stromberg-DS/KindnessFlower/Graphics/FlowerBase.JPEG

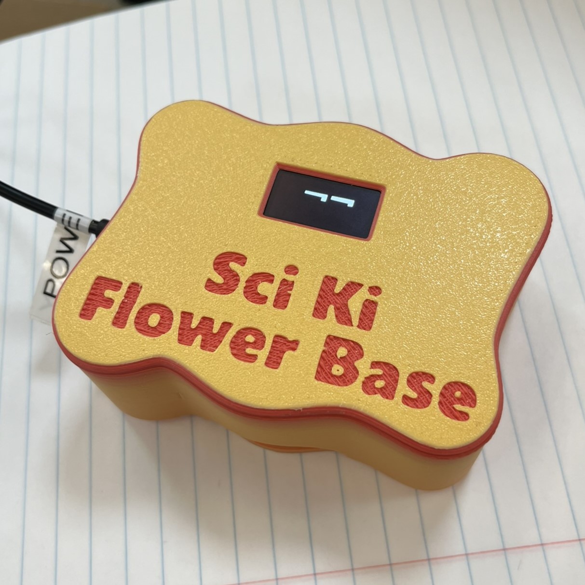
Graphics/FlowerBase.JPEG
