stromberg-DS/KindnessFlower/Graphics/FlowerBase_Wiggly.png

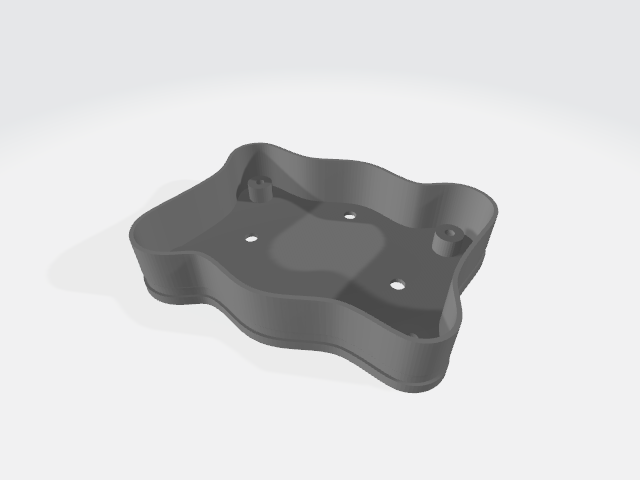
Graphics/FlowerBase_Wiggly.png
