stromberg-DS/KindnessFlower/Graphics/FlowerLid_Wiggly.png

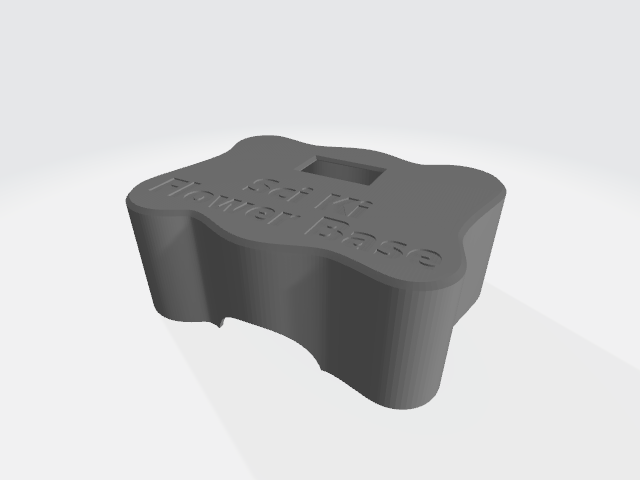
Graphics/FlowerLid_Wiggly.png
