stromberg-DS/KindnessFlower/Graphics/KindFlowerPCB2.png

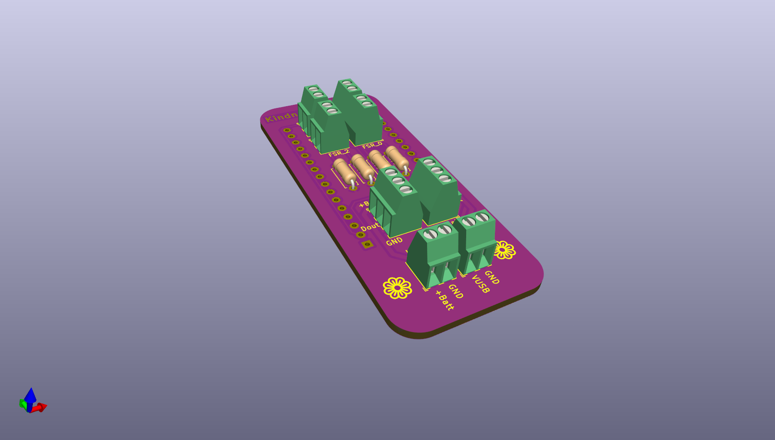
Graphics/KindFlowerPCB2.png
