stromberg-DS/KindnessFlower/Graphics/KindFlowerPCB.png

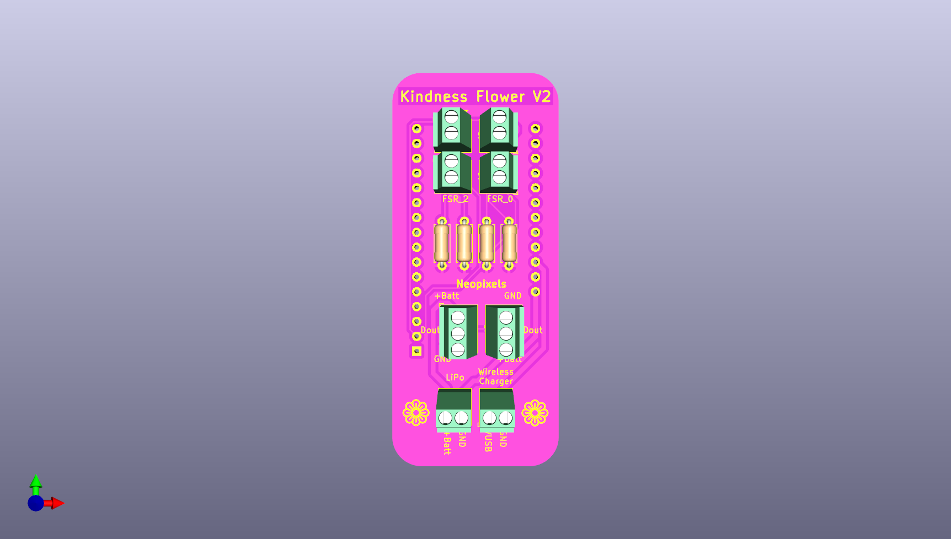
Graphics/KindFlowerPCB.png
