stromberg-DS/KindnessFlower/3D_Files/FlowerBase_Wiggly.stl

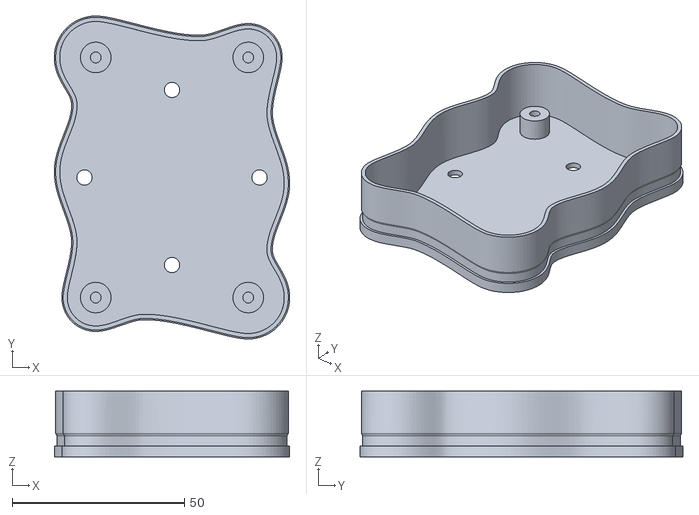
[picture p7: CAD file, 2024-09-27]
3D_Files/FlowerBase_Wiggly.stl
68.3 x 93.7 x 19.0
