stromberg-DS/KindnessFlower/3D_Files/FlowerLid_Wiggly.stl

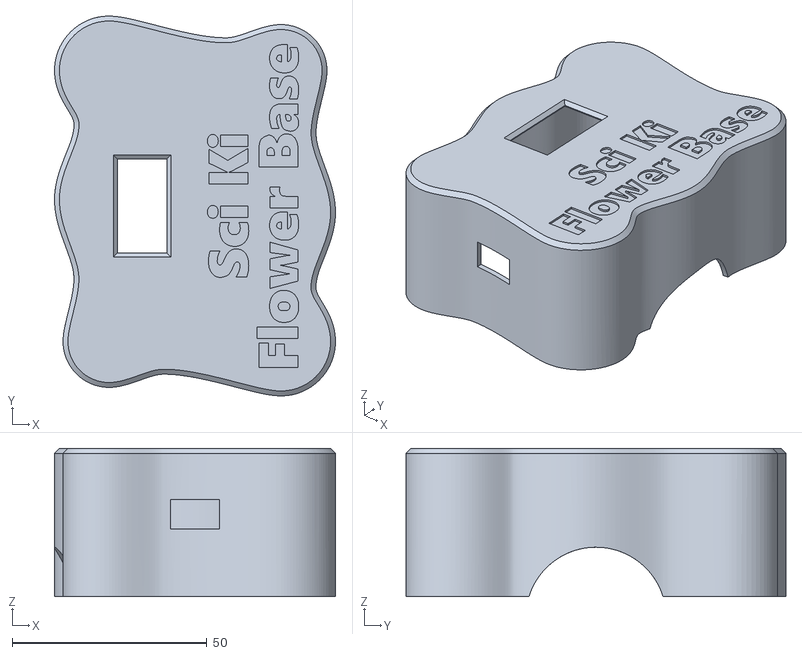
[picture p8: CAD file, 2024-09-27]
3D_Files/FlowerLid_Wiggly.stl
72.2 x 97.6 x 38.1
