stromberg-DS/KindnessFlower/WiringDiagrams/FlowerBase_bb.jpg

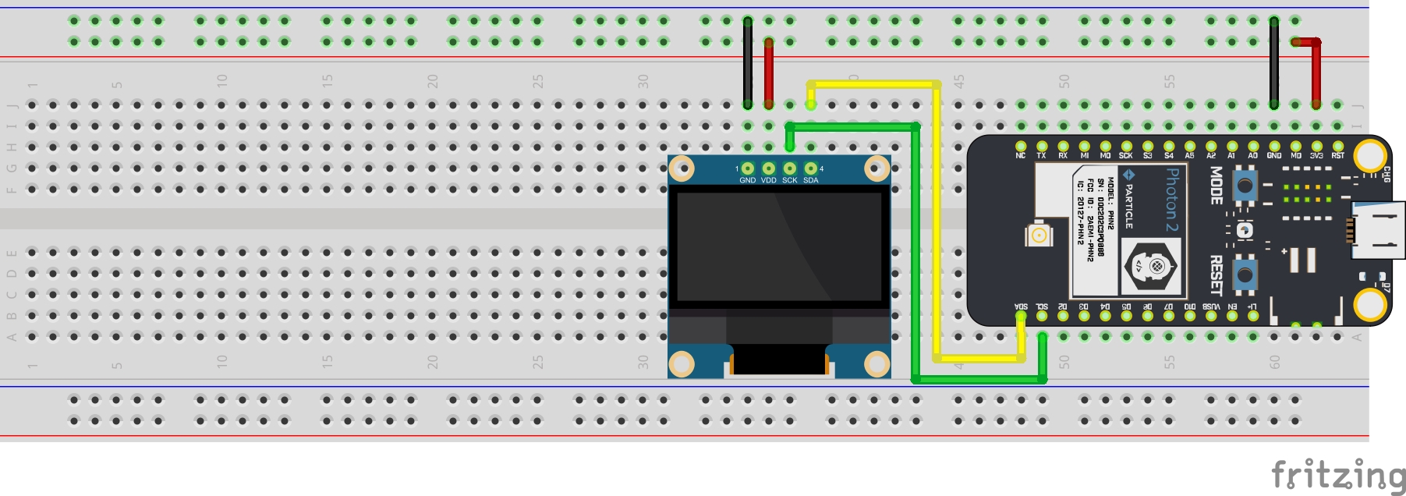
WiringDiagrams/FlowerBase_bb.jpg
