stromberg-DS/KindnessFlower/WiringDiagrams/FlowerBase_schem.jpg

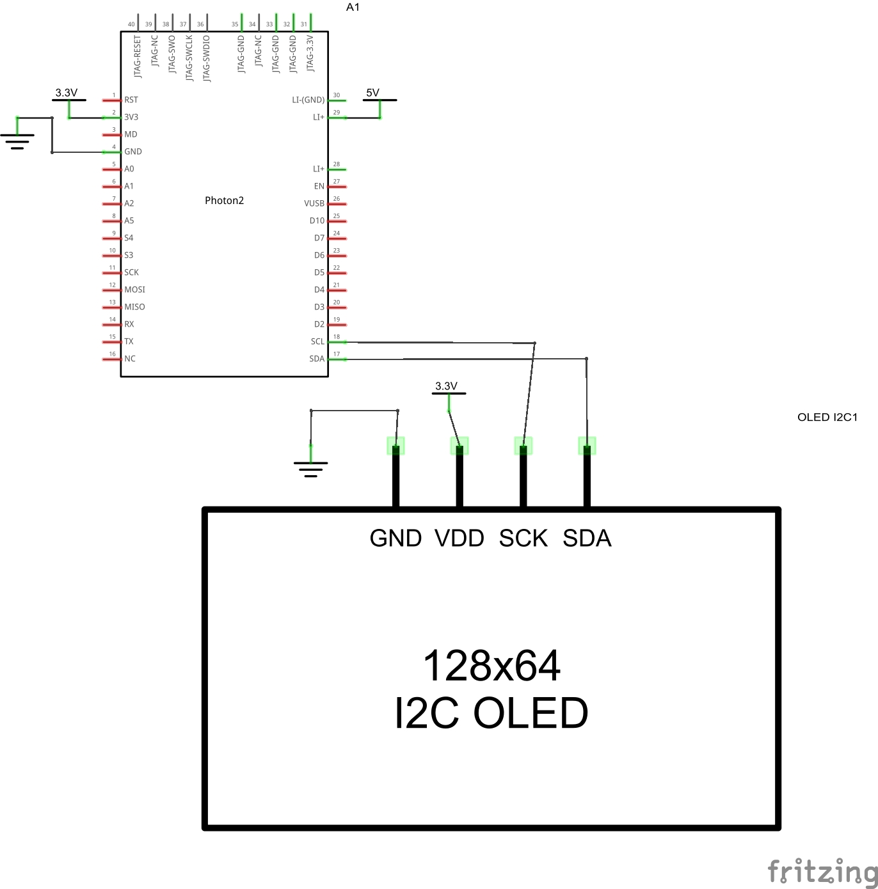
WiringDiagrams/FlowerBase_schem.jpg
