stromberg-DS/KindnessFlower/WiringDiagrams/FlowerWiring_bb.jpg

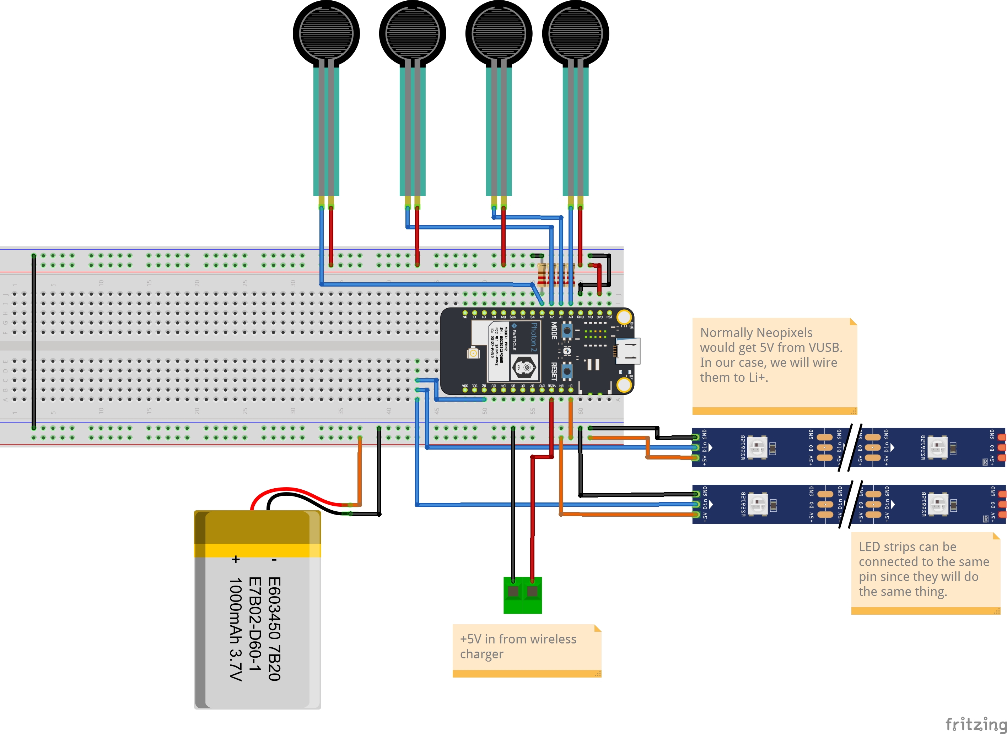
WiringDiagrams/FlowerWiring_bb.jpg
