stromberg-DS/KindnessFlower/WiringDiagrams/FlowerWiring_schem.jpg

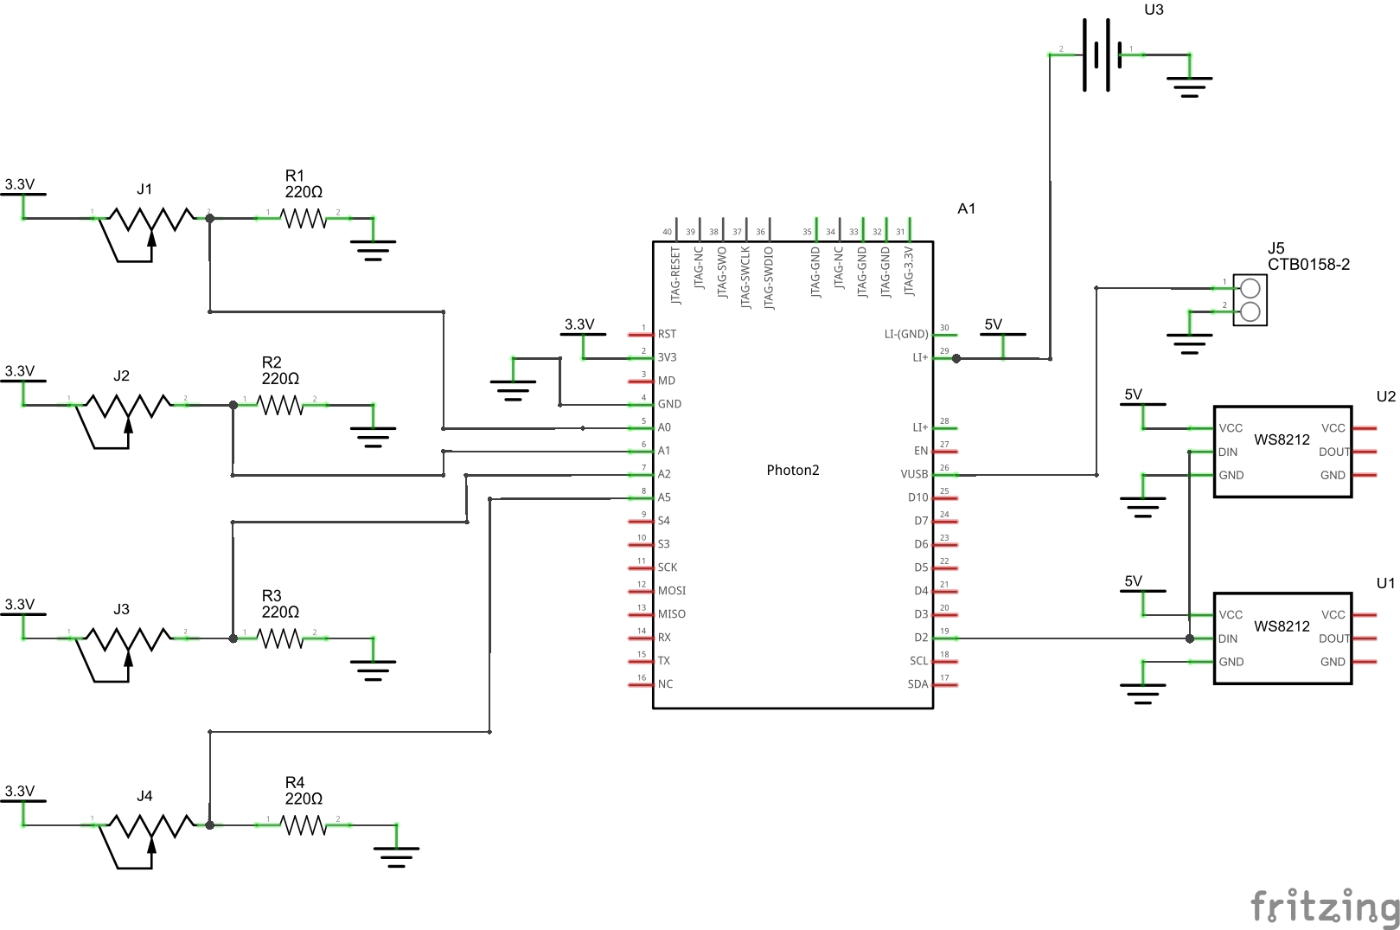
WiringDiagrams/FlowerWiring_schem.jpg
