stromberg-DS/KindnessFlower/Graphics/KindFlowerFlow.pdf

# Kindness Flowers Basic Logic

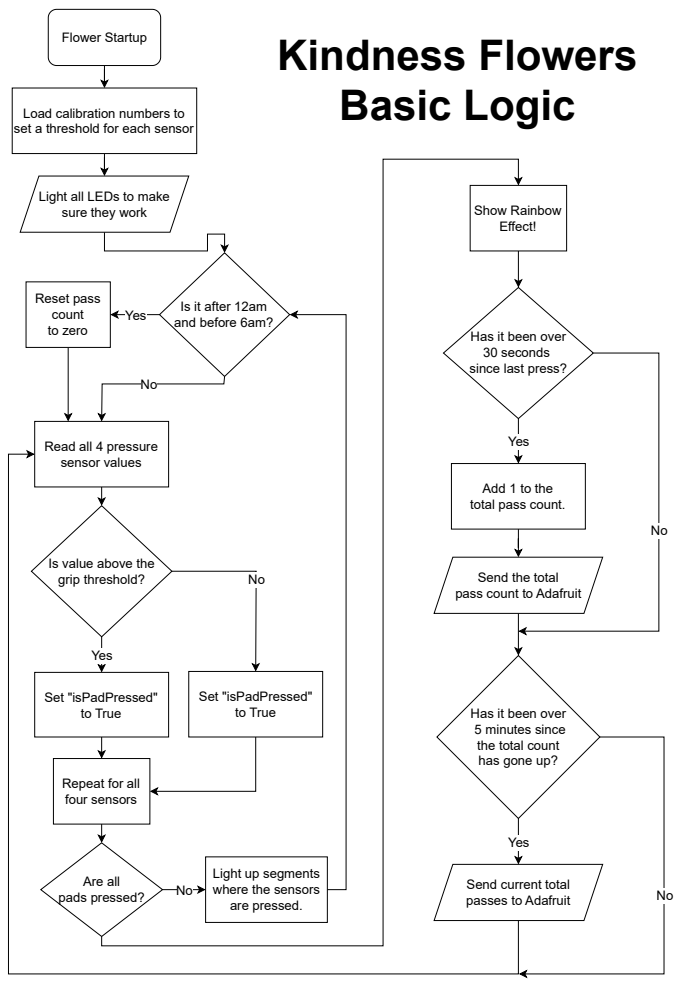
[picture p13: page 1]
Flower Startup; Yes; Set "isPadPressed" to True; Are all pads pressed?; Show Rainbow Effect!; are pressed.; Reset pass count to zero

Load calibration numbers to
set a threshold for each sensor

Light all LEDs to make
sure they work

Is it after 12am
and before 6am?

Has it been over
30 seconds
since last press?

Read all 4 pressure
sensor values

Add 1 to the
total pass count.

Is value above the
grip threshold?

Send the total
pass count to Adafruit

5 minutes since
the total count
has gone up?

Repeat for all
four sensors

Light up segments
where the sensors

Send current total
passes to Adafruit

# Flower Base Logic

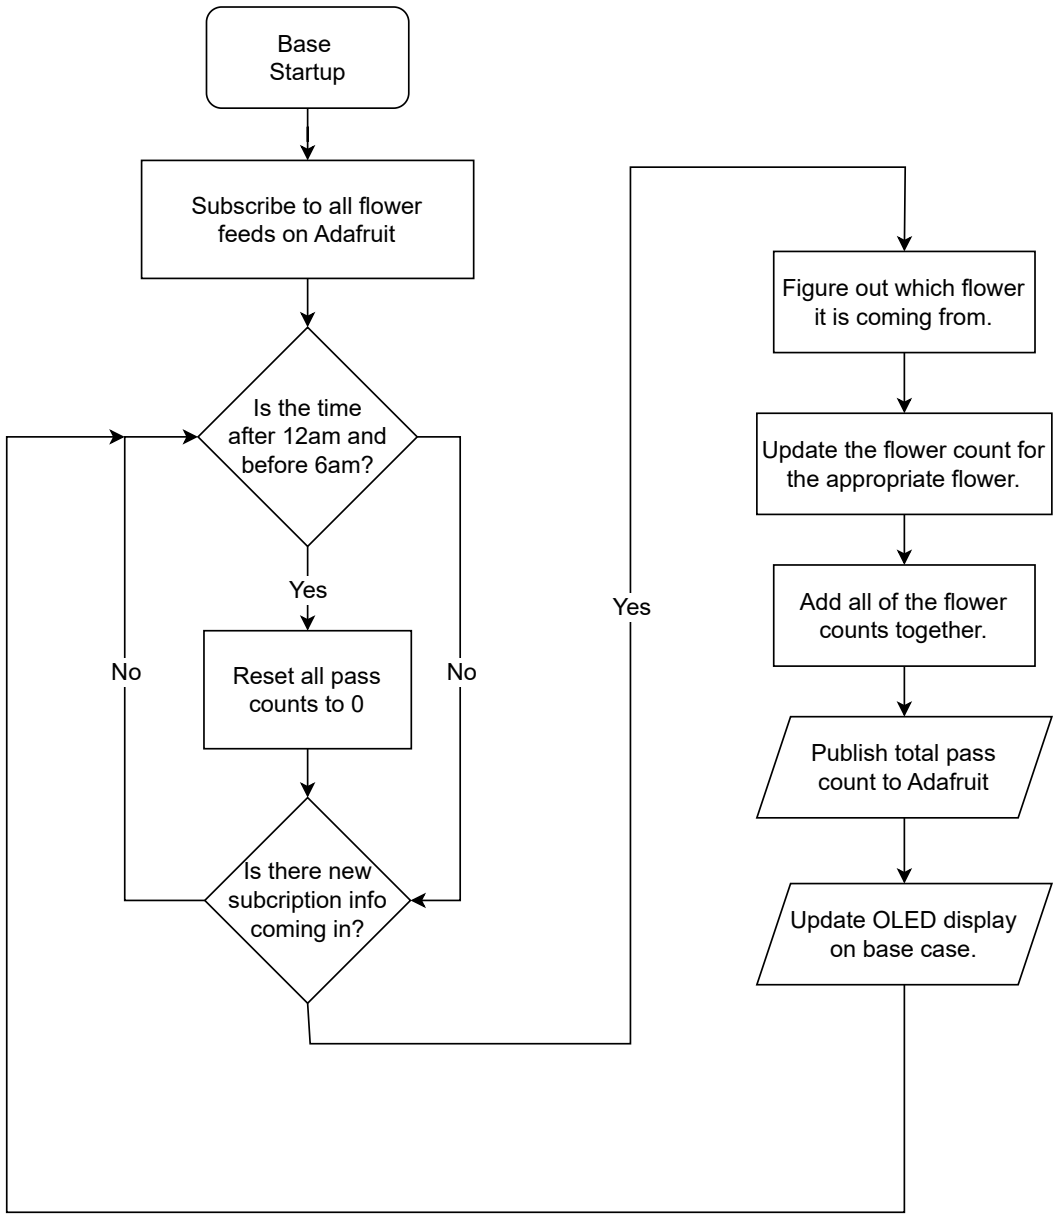
[picture p14: figure]
Base Startup; Subscribe to all flower feeds on Adafruit; Is the time after 12am and before 6am?; Reset all pass counts to 0; Is there new subcription info coming in?; Figure out which flower it is coming from.; Yes; Update the flower count for the appropriate flower.; Add all of the flower counts together.; Publish total pass count to Adafruit; Update OLED display on base case.

# Flower Pressure Calibration Logic

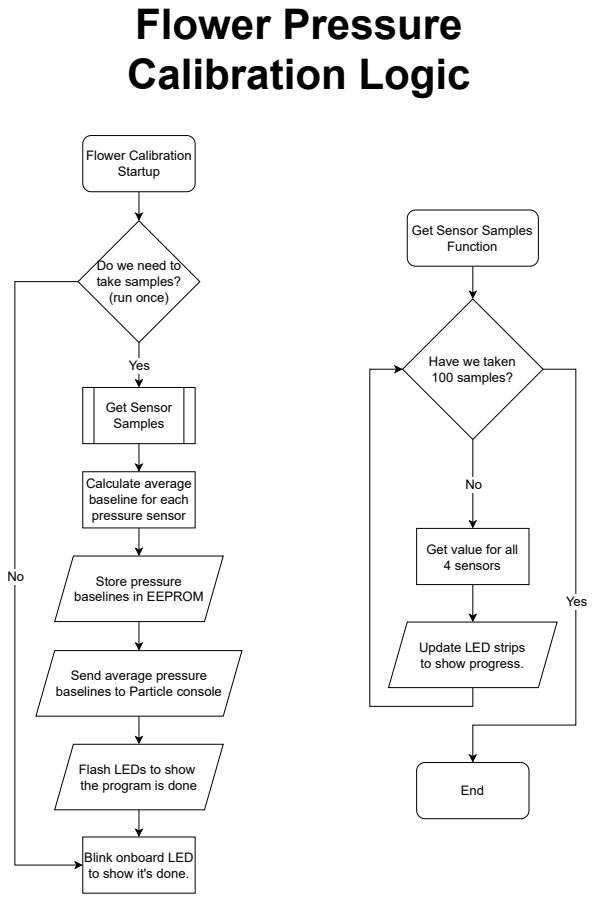
[picture p15: page 3]
Yes; End; Flower Calibration Startup; Get Sensor Samples

Get Sensor Samples
Function

Do we need to
take samples?
(run once)

Yes

Have we taken

100 samples?

Calculate average
baseline for each
pressure sensor

Get value for all 4 sensors

Store pressure
baselines in EEPROM

Update LED strips
to show progress.

Send average pressure
baselines to Particle console

Flash LEDs to show
the program is done

Blink onboard LED
to show it's done.
