stromberg-DS/KindnessFlower/(list of files, drawings)

Other design files:
Other Tests/PressureSense_Tests/FSR_PressureSensorTest.fzz
WiringDiagrams/FlowerBase.fzz
WiringDiagrams/FlowerWiring.fzz
