stromberg-DS/KindnessFlower/Kindness_Flower/src/Kindness_Flower.cpp

/* 
 * Kindness Flower
 *      Portable flower that visitors take around the museum floor
 *      with them. When they pass the flower to someone else, they
 *      can light up the whole flower by grabbing all 4 pressure
 *      sensors. We tally up the number of passes as a proxy for
 *      kind acts. Future possibility of using BLE to find location
 *      throughout the museum and activate parts of the museum as 
 *      the flower gets closer.
 * Author: Daniel Stromberg
 * Date: 5/13/24
 * Parts:
 *      Use the Adafruit guide to set up FSRs from Adafruit (ID:1075)
 *      https://learn.adafruit.com/force-sensitive-resistor-fsr/using-an-fsr
 */

#include "Particle.h"
#include <neopixel.h>
#include "credentials.h"
#include <Adafruit_MQTT.h>
#include "Adafruit_MQTT/Adafruit_MQTT_SPARK.h"
#include "Adafruit_MQTT/Adafruit_MQTT.h"

////////KEEEP AUTOMATIC///////////
SYSTEM_MODE(AUTOMATIC);
/////////////////////////////////
SYSTEM_THREAD(ENABLED);

const int SENSOR_COUNT = 4;
const int PIXEL_COUNT = 112;
const int PIXELS_PER_SEGMENT = 28;
const int PRESSURE_PINS[SENSOR_COUNT] = {A5, A0, A2, A1};
int pressureBaselines[SENSOR_COUNT];
int gripThreshold[SENSOR_COUNT];    //NewThreshold values: halfway between baseline and max (4096)

//EEPROM Setup 
int len = EEPROM.length();
const int BASELINE_ADDRESS = 0x0001;    //length of 4x ints is 16 bytes (4 bytes per)
//start COUNT_ADDRESS at 0x0014 (or 21 in decimal) to put some space between
//      it and BASELINE_ADDRESS which ends at 0x0011 (or 17 in decimal)
const int COUNT_ADDRESS = 0x0015;


int brightness = 255;
int pixelDelay = 50;
unsigned long pixelPrevious = 0;
int pixelCycle = 0;
int pressureIn[SENSOR_COUNT];
bool areAllPressed = false;
bool isPadPressed[SENSOR_COUNT];

int passCount;
bool isFirstPass = true;
double batVoltage;
int batPin = A6;
unsigned int lastPublishTime = 0;
unsigned int lastPassTime = 0;
unsigned int lastSensorPrintTime = 0;
unsigned int lastIdleUpdate = 0;

String DateTime, TimeOnly, HourOnly;
bool doesCountNeedReset = false;
int currentHour;
int currentMinute;

Adafruit_NeoPixel pixel(PIXEL_COUNT, SPI1, WS2812);
TCPClient TheClient;
Adafruit_MQTT_SPARK mqtt(&TheClient, AIO_SERVER, AIO_SERVERPORT, AIO_USERNAME, AIO_KEY);
// Adafruit_MQTT_Publish battPub = Adafruit_MQTT_Publish(&mqtt, AIO_USERNAME "/feeds/flower3battery");


//////UNCOMMENT THE FLOWER NUMBER BELOW THAT YOU WANT TO FLASH/////
//
// Adafruit_MQTT_Publish passPub = Adafruit_MQTT_Publish(&mqtt, AIO_USERNAME "/feeds/flower1passcount");
// Adafruit_MQTT_Publish passPub = Adafruit_MQTT_Publish(&mqtt, AIO_USERNAME "/feeds/flower2passcount");
Adafruit_MQTT_Publish passPub = Adafruit_MQTT_Publish(&mqtt, AIO_USERNAME "/feeds/flower3passcount");
// Adafruit_MQTT_Publish passPub = Adafruit_MQTT_Publish(&mqtt, AIO_USERNAME "/feeds/flower4passcount");
// Adafruit_MQTT_Publish passPub = Adafruit_MQTT_Publish(&mqtt, AIO_USERNAME "/feeds/flower5passcount");
// Adafruit_MQTT_Publish passPub = Adafruit_MQTT_Publish(&mqtt, AIO_USERNAME "/feeds/flower6passcount");


//functions
void MQTT_connect();
bool MQTT_ping();
void ledStripStartup();
void ledFill(int color, int firstLED = 0, int lastLED = PIXEL_COUNT);
uint32_t wheel(byte wheelPos);
void rainbow(uint8_t wait);
int resetCount(String command);     //particle function to be called from particle console

void setup() {
    Serial.begin(9600);
    waitFor(Serial.isConnected, 10000);
    EEPROM.get(BASELINE_ADDRESS, pressureBaselines);
    EEPROM.get(COUNT_ADDRESS, passCount);
    if(passCount<0) passCount=0;

    Watchdog.init(WatchdogConfiguration().timeout(600s));   //Set watchdog timer to 5 min
    Watchdog.start();                                       //Start watchdog timer

    Time.zone(-7);
    Particle.syncTime();
    
    int pressVarSize = sizeof(pressureBaselines);
    Serial.printf("Size of pressureBaselines: %i\n", pressVarSize);
    pinMode(batPin, INPUT);
    ledStripStartup();

    Particle.variable("BatteryVoltage", batVoltage);
    Particle.variable("Pass Count", passCount);
    Particle.function("ResetCount", resetCount);

    Serial.printf("#### Incoming Average Baselines ####\n");
    for(int i=0; i<SENSOR_COUNT; i++){
        pinMode(PRESSURE_PINS[i], INPUT);
        Serial.printf("Last Avg #%i: %i\n",i , pressureBaselines[i]);
        gripThreshold[i] = int((4096-pressureBaselines[i])/2);      //set to halfway between baseline and max
    }
    Serial.printf("\n\n");
}

void loop() {
    Watchdog.refresh();     //Watchdog timer checks in every loop.
    MQTT_connect();
    MQTT_ping();
    batVoltage = analogRead(batPin)/819.2;

    DateTime = Time.timeStr();
    TimeOnly = DateTime.substring(11,19);
    HourOnly = DateTime.substring(11, 13);
    currentHour =  atoi(HourOnly);

    if(doesCountNeedReset && currentHour<6){
        passCount=0;
        Particle.publish("Passcount reset to 0");
        doesCountNeedReset = false;
        EEPROM.put(COUNT_ADDRESS, passCount);
    }else if(currentHour>=23){
        doesCountNeedReset = true;
    }
    

    for(int i=0; i<SENSOR_COUNT; i++){
        pressureIn[i] = analogRead(PRESSURE_PINS[i]);
    }

    // Assume all are pressed until we find one that is not pressed
    areAllPressed = true;
    for(int j=0; j<SENSOR_COUNT; j++){
        if(pressureIn[j] - pressureBaselines[j] > gripThreshold[j]){    //was gripStrength
            isPadPressed[j] = true;
        } else{
            isPadPressed[j] = false;
            areAllPressed = false;
        }
    }

    if(areAllPressed){
        // Show Rainbow display
        if(millis() - pixelPrevious >= pixelDelay){
            pixelPrevious = millis();
            rainbow(1);
        }
    } else{
        isFirstPass = true;
        for(int k=0; k<SENSOR_COUNT; k++){
            if((isPadPressed[k])){
                ledFill(0x00FF00, k*PIXELS_PER_SEGMENT, (k+1)*PIXELS_PER_SEGMENT);
            } else{
                ledFill(0, k*PIXELS_PER_SEGMENT, (k+1)*PIXELS_PER_SEGMENT);
            }

        }
    }
    
    if(isFirstPass && areAllPressed && (millis()-lastPassTime > 30000)){
        passCount++;
        EEPROM.put(COUNT_ADDRESS, passCount);
        if(mqtt.Update()){                  //included update for more responsive screen
            passPub.publish(passCount);
        }
        lastPassTime = millis();        
        lastIdleUpdate = millis();      //reset idle update timer
        isFirstPass = false;
        Serial.printf("Pass Count: %i\n", passCount);
        Particle.publish("Pass Count", String(passCount));
    }

    //Update the passCount every 5 minutes if noone has touched it.
    //  This allows the FlowerBase to be accurated even if it has been
    //  reset.
    if((millis() - lastIdleUpdate)>300000){ 
        if(mqtt.Update()){
            passPub.publish(passCount);
        }
        lastIdleUpdate = millis();
    }

    //Send data to Adafruit every 5 min
    //
    // if(millis() - lastPublishTime > 300000){    //send data every 5 minutes
    //     if(mqtt.Update()){
    //         battPub.publish(batVoltage);
    //         // passPub.publish(passCount);
    //     }
    //     lastPublishTime = millis();
    // }

    if(millis()-lastSensorPrintTime >1000){
        Serial.printf("passCount: %i\n", passCount);
        for (int i=0; i<4; i++){
            Serial.printf("Sensor %i Value: %04i:%04i\n", i, pressureIn[i], gripThreshold[i]);
        }
        Serial.printf("\nDateTime: %s\n", DateTime.c_str());
        Serial.printf("TimeOnly: %s\n", TimeOnly.c_str());
        Serial.printf("Hour: %i\n", currentHour);
        lastSensorPrintTime = millis();
        Serial.printf("\n");
    }
    pixel.show();
}

void ledFill(int color, int firstLED, int lastLED) {
    for (int i=firstLED; i<lastLED; i++){
        pixel.setPixelColor(i, color);
    }
}

void ledStripStartup(){
    pixel.begin();
    pixel.setBrightness(brightness/2);
    pixel.clear();
    pixel.show();

    //Quick test of all LEDs to make sure the strip works. 
    for (int i=0; i < PIXEL_COUNT; i++){
        // pixel.clear();
        pixel.setPixelColor(i, 0x00FF99);
        pixel.show();
        delay(20);
    }

    delay(1000);

    pixel.clear();
    pixel.show();
    pixel.setBrightness(brightness);
}

void rainbow(uint8_t wait){
    if(pixelDelay != wait){
        pixelDelay = wait;
    }

    for(uint16_t i=0; i<PIXEL_COUNT; i++){
        pixel.setPixelColor(i, wheel((i+pixelCycle) &255));
    }
    pixel.show();
    pixelCycle++;
    if(pixelCycle >= 256){
        pixelCycle =0;
    }
}

//No i don't understand exactly what this does
//input a value 0-255 to get a color value.
uint32_t wheel(byte wheelPos){
    wheelPos = 255 - wheelPos;
    if(wheelPos < 85){
        return pixel.Color(255-wheelPos*3, 0, wheelPos * 3);
    }

    if(wheelPos < 170){
        wheelPos -= 85;
        return pixel.Color(0, wheelPos*3, 255-wheelPos*3);
    }
    wheelPos -=170;
    return pixel.Color(wheelPos*3, 255-wheelPos*3, 0);
}

// Function to connect and reconnect as necessary to the MQTT server.
// Should be called in the loop function and it will take care of connecting.
void MQTT_connect(){
    int8_t ret;

    // Return if already connected.
    if (mqtt.connected()){
        return;
    }

    Serial.print("Connecting to MQTT... ");

    while((ret = mqtt.connect()) != 0){
        Serial.printf("Error Code %s\n", mqtt.connectErrorString(ret));
        Serial.printf("Retrying MQTT connection in 5 seconds...\n");
        mqtt.disconnect();
        delay(5000);
    }
    Serial.printf("MQTT Connected!\n");
}

//Keeps the connection open to Adafruit
bool MQTT_ping() {
    static unsigned int last;
    bool pingStatus;

    if ((millis()-last)>120000) {
        Serial.printf("Pinging MQTT \n");
        pingStatus = mqtt.ping();
        if(!pingStatus) {
        Serial.printf("Disconnecting \n");
        mqtt.disconnect();
        }
        last = millis();
    }
    return pingStatus;
}

//This function can be called from the particle console.
//  That way, we can reset the count to 0 from anywhere.
int resetCount(String command){
    if(command == "reset"){
        passCount = 0;
        EEPROM.put(COUNT_ADDRESS, passCount);
        
        if(mqtt.Update()){
            passPub.publish(passCount);
        }
        return 1;
    }else{
        return -1;
    }
}
