stromberg-DS/KindnessFlower/(commit log)

2024-04-11 Touch Sensors Working
2024-04-15 Lighting up LEDs when wires are touched.
2024-05-07 Overdue update
    [FSR_PressureSensorTest.fzz]
2024-05-07 Added FSR to fritzing wiring
    [FSR_PressureSensorTest.fzz]
2024-05-07 One pressure zone lights up
2024-05-07 Added all pressure pads to breadboard
    [FSR_PressureSensorTest.fzz]
2024-05-08 Sensor arrays fill with data
2024-05-08 Averaging one set of samples
2024-05-08 Get average for all sensors, yay!
2024-05-08 Set device as SciKiFlower_1
2024-05-08 Added blinking status LED after taking 100 samples
2024-05-08 Pixel check only does one pixel at a time to reduce current needs.
2024-05-09 Fixed number of pixels in each segment
    [LED_patternsTest.cpp]
2024-05-09 Created main wiring diagram
    [FlowerWiring.fzz]
2024-05-09 Updated wiring with all components
    [FSR_PressureSensorTest.fzz]
2024-05-09 Updated wiring
2024-05-13 Changed number of sensors to 4
2024-05-13 Created final project for flower code
2024-05-13 Dropped to 4 sensors
2024-05-13 Updated resistor values
    [FlowerWiring.fzz]
2024-05-13 Added passcounter, battery voltage monitoring
2024-05-15 Flower updates to Adafruit.io
2024-05-17 Created KiCAD file to get PCB made
    [FlowerWiring.fzz, KindFlowerPCB.kicad_pcb, KindFlowerPCB.kicad_sch]
2024-05-17 PCB file updates
    [KindFlowerPCB.kicad_pcb, KindFlowerPCB.kicad_sch]
2024-05-20 Updated KiCad files, redesigned PCB
    [KindFlowerPCB-B_Cu.gbr, KindFlowerPCB-B_Mask.gbr, KindFlowerPCB-B_Paste.gbr, KindFlowerPCB-B_Silkscreen.gbr, KindFlowerPCB-Edge_Cuts.gbr, KindFlowerPCB-F_Cu.gbr, KindFlowerPCB-F_Mask.gbr, KindFlowerPCB-F_Paste.gbr]
2024-05-24 Made power traces thicker
    [KindFlowerPCB.kicad_pcb]
2024-05-24 Created test file for testing PCBs
2024-05-24 Make power traces thicker
    [KindFlowerPCB.kicad_pcb]
2024-06-03 Added test for PCBs
2024-06-03 Updated PCB files
    [KindFlowerPCB-B_Cu.gbr, KindFlowerPCB-B_Mask.gbr, KindFlowerPCB-B_Paste.gbr, KindFlowerPCB-B_Silkscreen.gbr, KindFlowerPCB-Edge_Cuts.gbr, KindFlowerPCB-F_Cu.gbr, KindFlowerPCB-F_Mask.gbr, KindFlowerPCB-F_Paste.gbr]
2024-06-03 Prints all sensor outputs
2024-06-07 backlog of changes
    [FlowerWiring.fzz]
2024-06-07 Added OLED, printing to screen
2024-09-16 Updated PCBs
2024-09-16 Flower base is collecting from Flower3 and adding to total pass count.
2024-09-16 Flashed 4 flowers. All reporting well.
2024-09-17 Flowers update their count every 5 minutes if noone has touched it.
2024-09-18 Fixed some incorrect flower count and sub variables.
    [FlowerBase.cpp]
2024-09-24 Added wiring diagrams for the Flower Base
    [FlowerBase.fzz]
2024-09-24 PCB backups updated
2024-09-25 Added OLED and flower drawing capability
2024-09-25 Added flowchart for flower logic.
2024-09-25 Added flower animations when data comes in.
2024-09-26 Save passcounts to EEPROM and reset at 1AM.
    [Kindness_Flower.cpp]
2024-09-27 Added logic flow charts.
2024-09-27 Added overnight counter reset for flower base.
    [FlowerBase.cpp]
2024-09-27 Adjusted startup LEDs to be less intense.
2024-09-27 Added Flower Base case STL files.
    [FlowerBase_Wiggly.stl, FlowerLid_Wiggly.stl]
2024-09-30 Saves pass count reset to EEPROM.
    [Kindness_Flower.cpp]
2024-09-30 Added particle function to reset pass count remotely.
    [Kindness_Flower.cpp]
2024-10-22 Added watchdog timer
